itelmex/openledsign/hardware/kicad/openled_esquematico.pdf

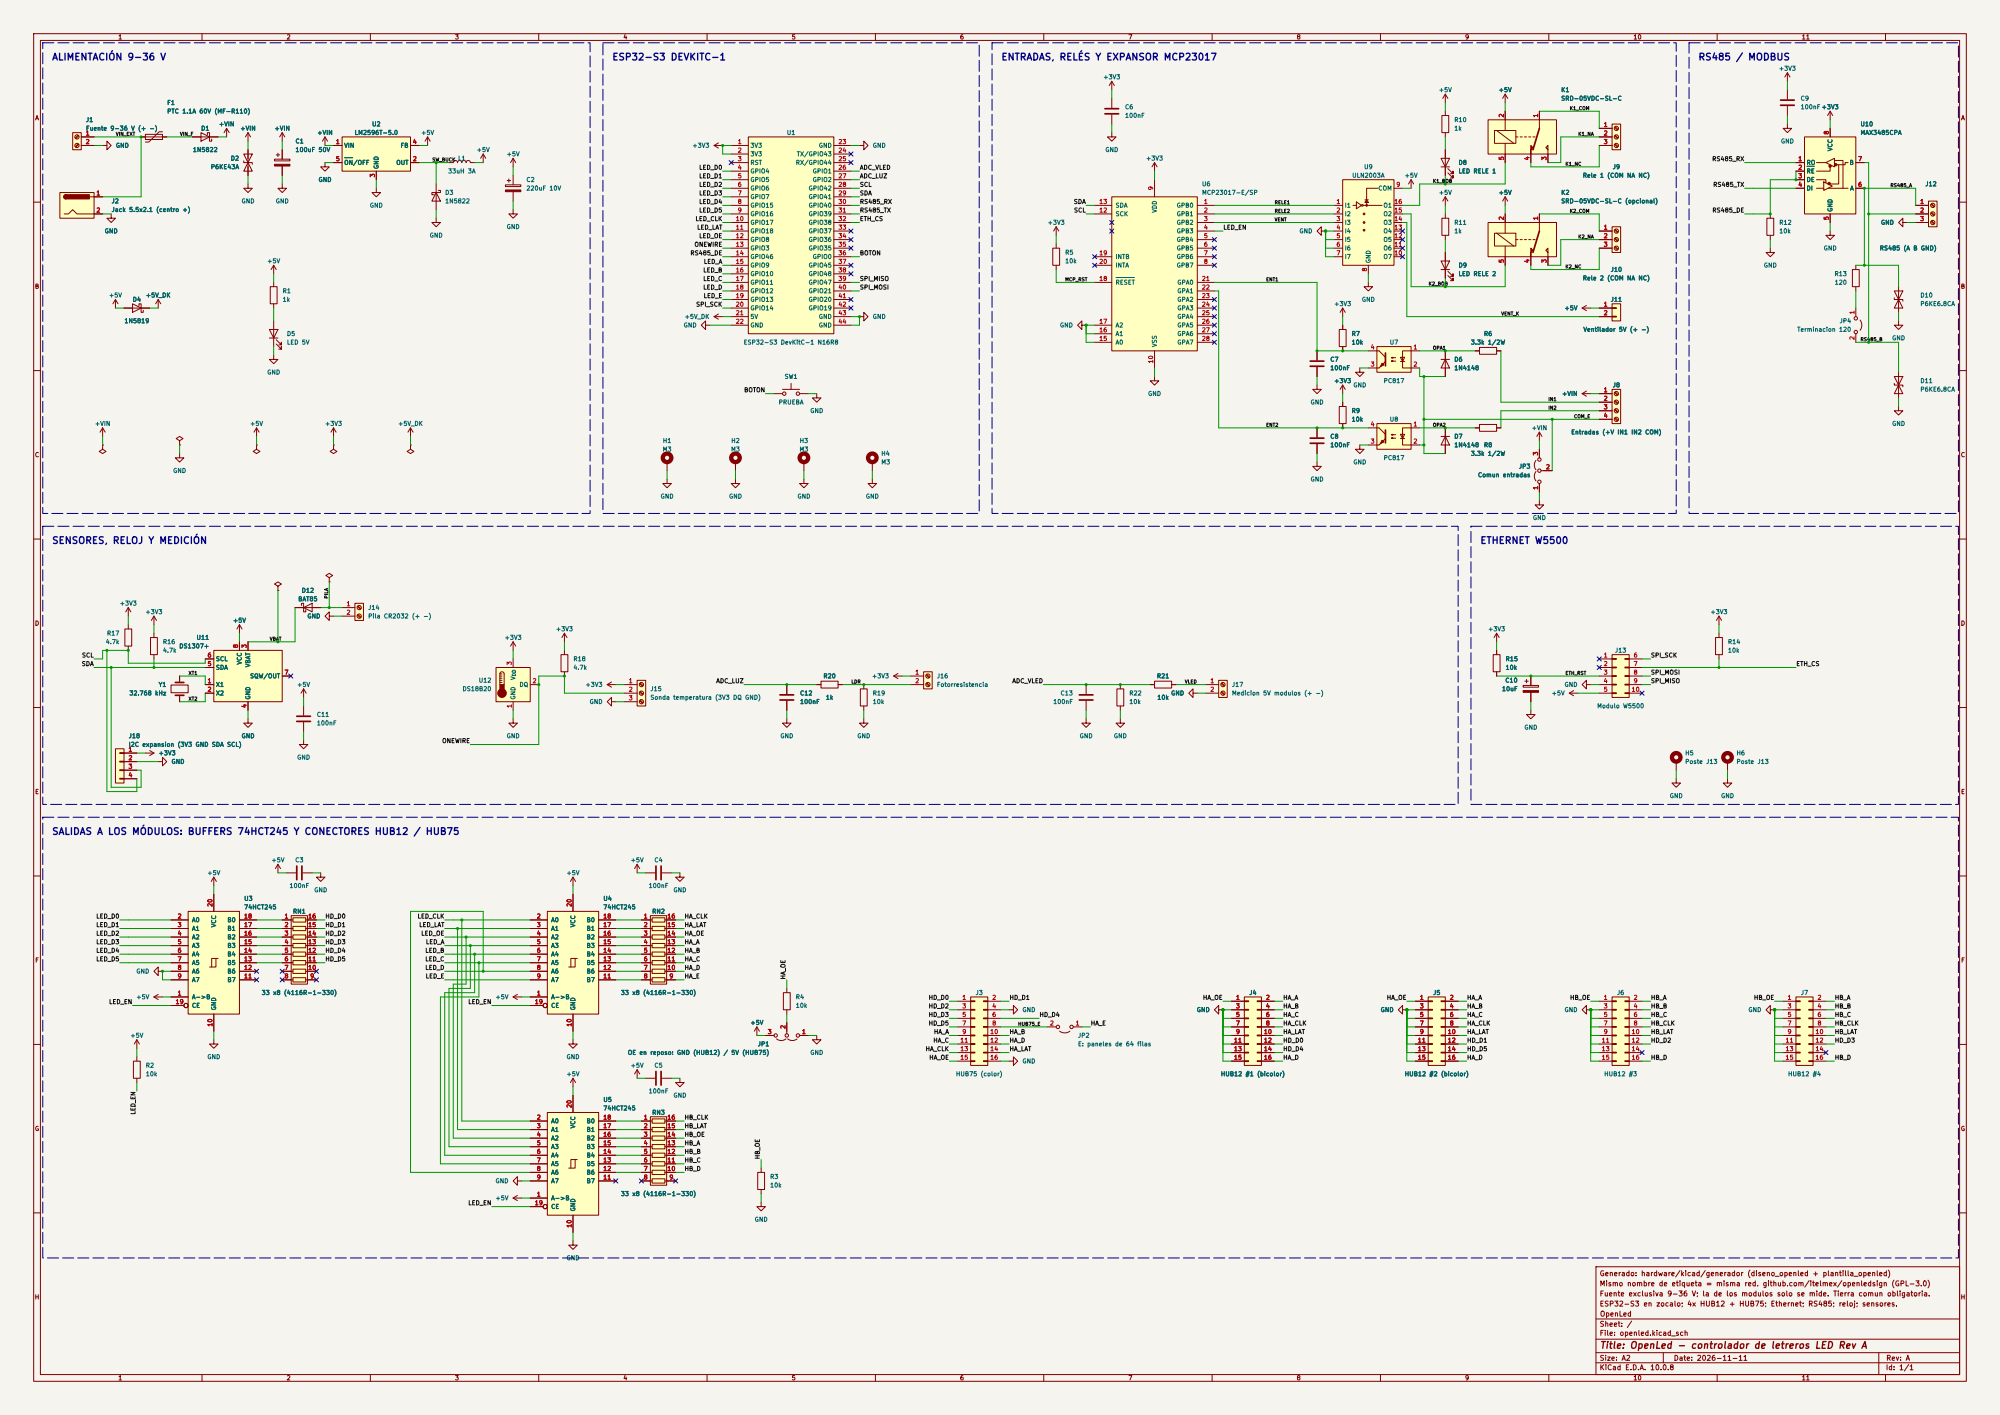
[picture p1: page 1]

J9 Rele 1 (COM NA NC) 1

J10 Rele 2 (COM NA NC) 1

Sonda temperatura (3V3 DQ GND) GND

I2C expansion (3V3 GND SDA SCL)GND

SALIDAS A LOS MÓDULOS: BUFFERS 74HCT245 Y CONECTORES HUB12 / HUB75

9 | 10
11 | 12

JP1 OE en reposo: GND (HUB12) / 5V (HUB75) A->B 1

A3 5 | 33 x8 (4116R-1-330) 1 4 4
A1 3 | 2 2
A2 4 | 3 3

A4 6 | 5 5
A5 7 | 6 6

Generado: hardware/kicad/generador (diseno_openled + plantilla_openled)
Mismo nombre de etiqueta = misma red. github.com/itelmex/openledsign (GPL-3.0)
ESP32-S3 en zocalo; 4x HUB12 + HUB75; Ethernet; RS485; reloj; sensores. Fuente exclusiva 9-36 V; la de los modulos solo se mide. Tierra comun obligatoria.

OpenLed
Sheet: /
File: openled.kicad_sch
Title: OpenLed - controlador de letreros LED Rev A

Size: A2 | Rev: A
KiCad E.D.A. 10.0.8 | Id: 1/1
