itelmex/openledsign/hardware/kicad/openled.kicad_sch

## KiCad design hardware/kicad/openled.kicad_sch (2026-11-11)

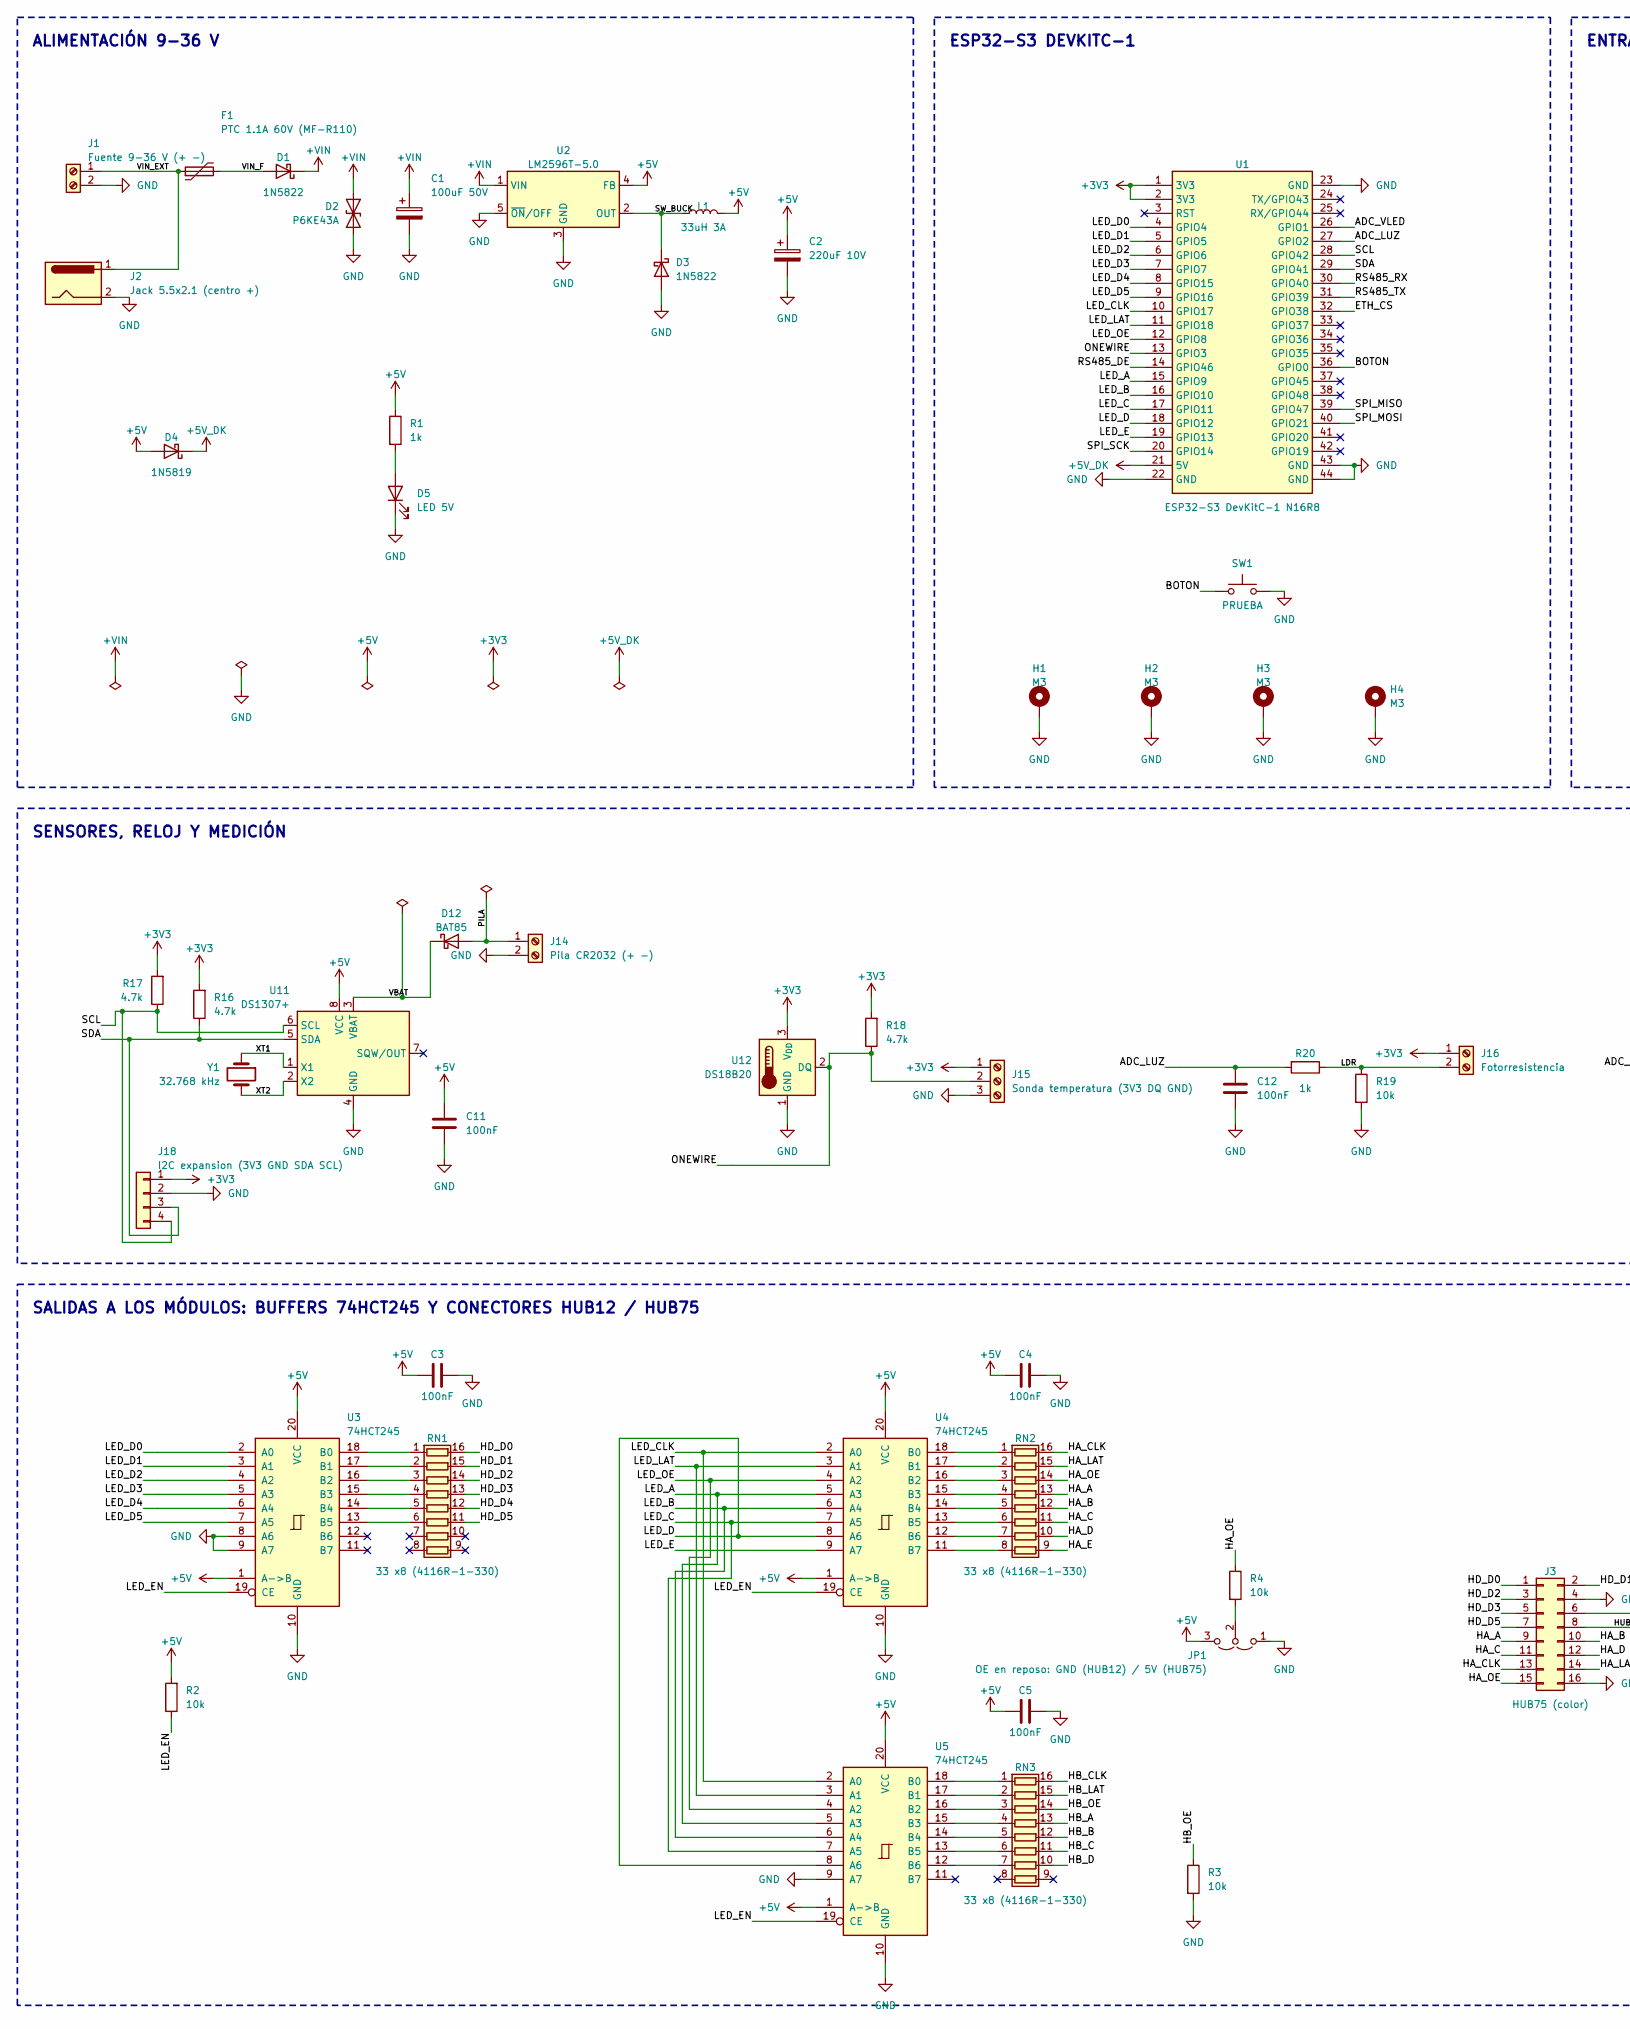
[picture p2: schematic openled.kicad_sch, part in row 1, column 1]

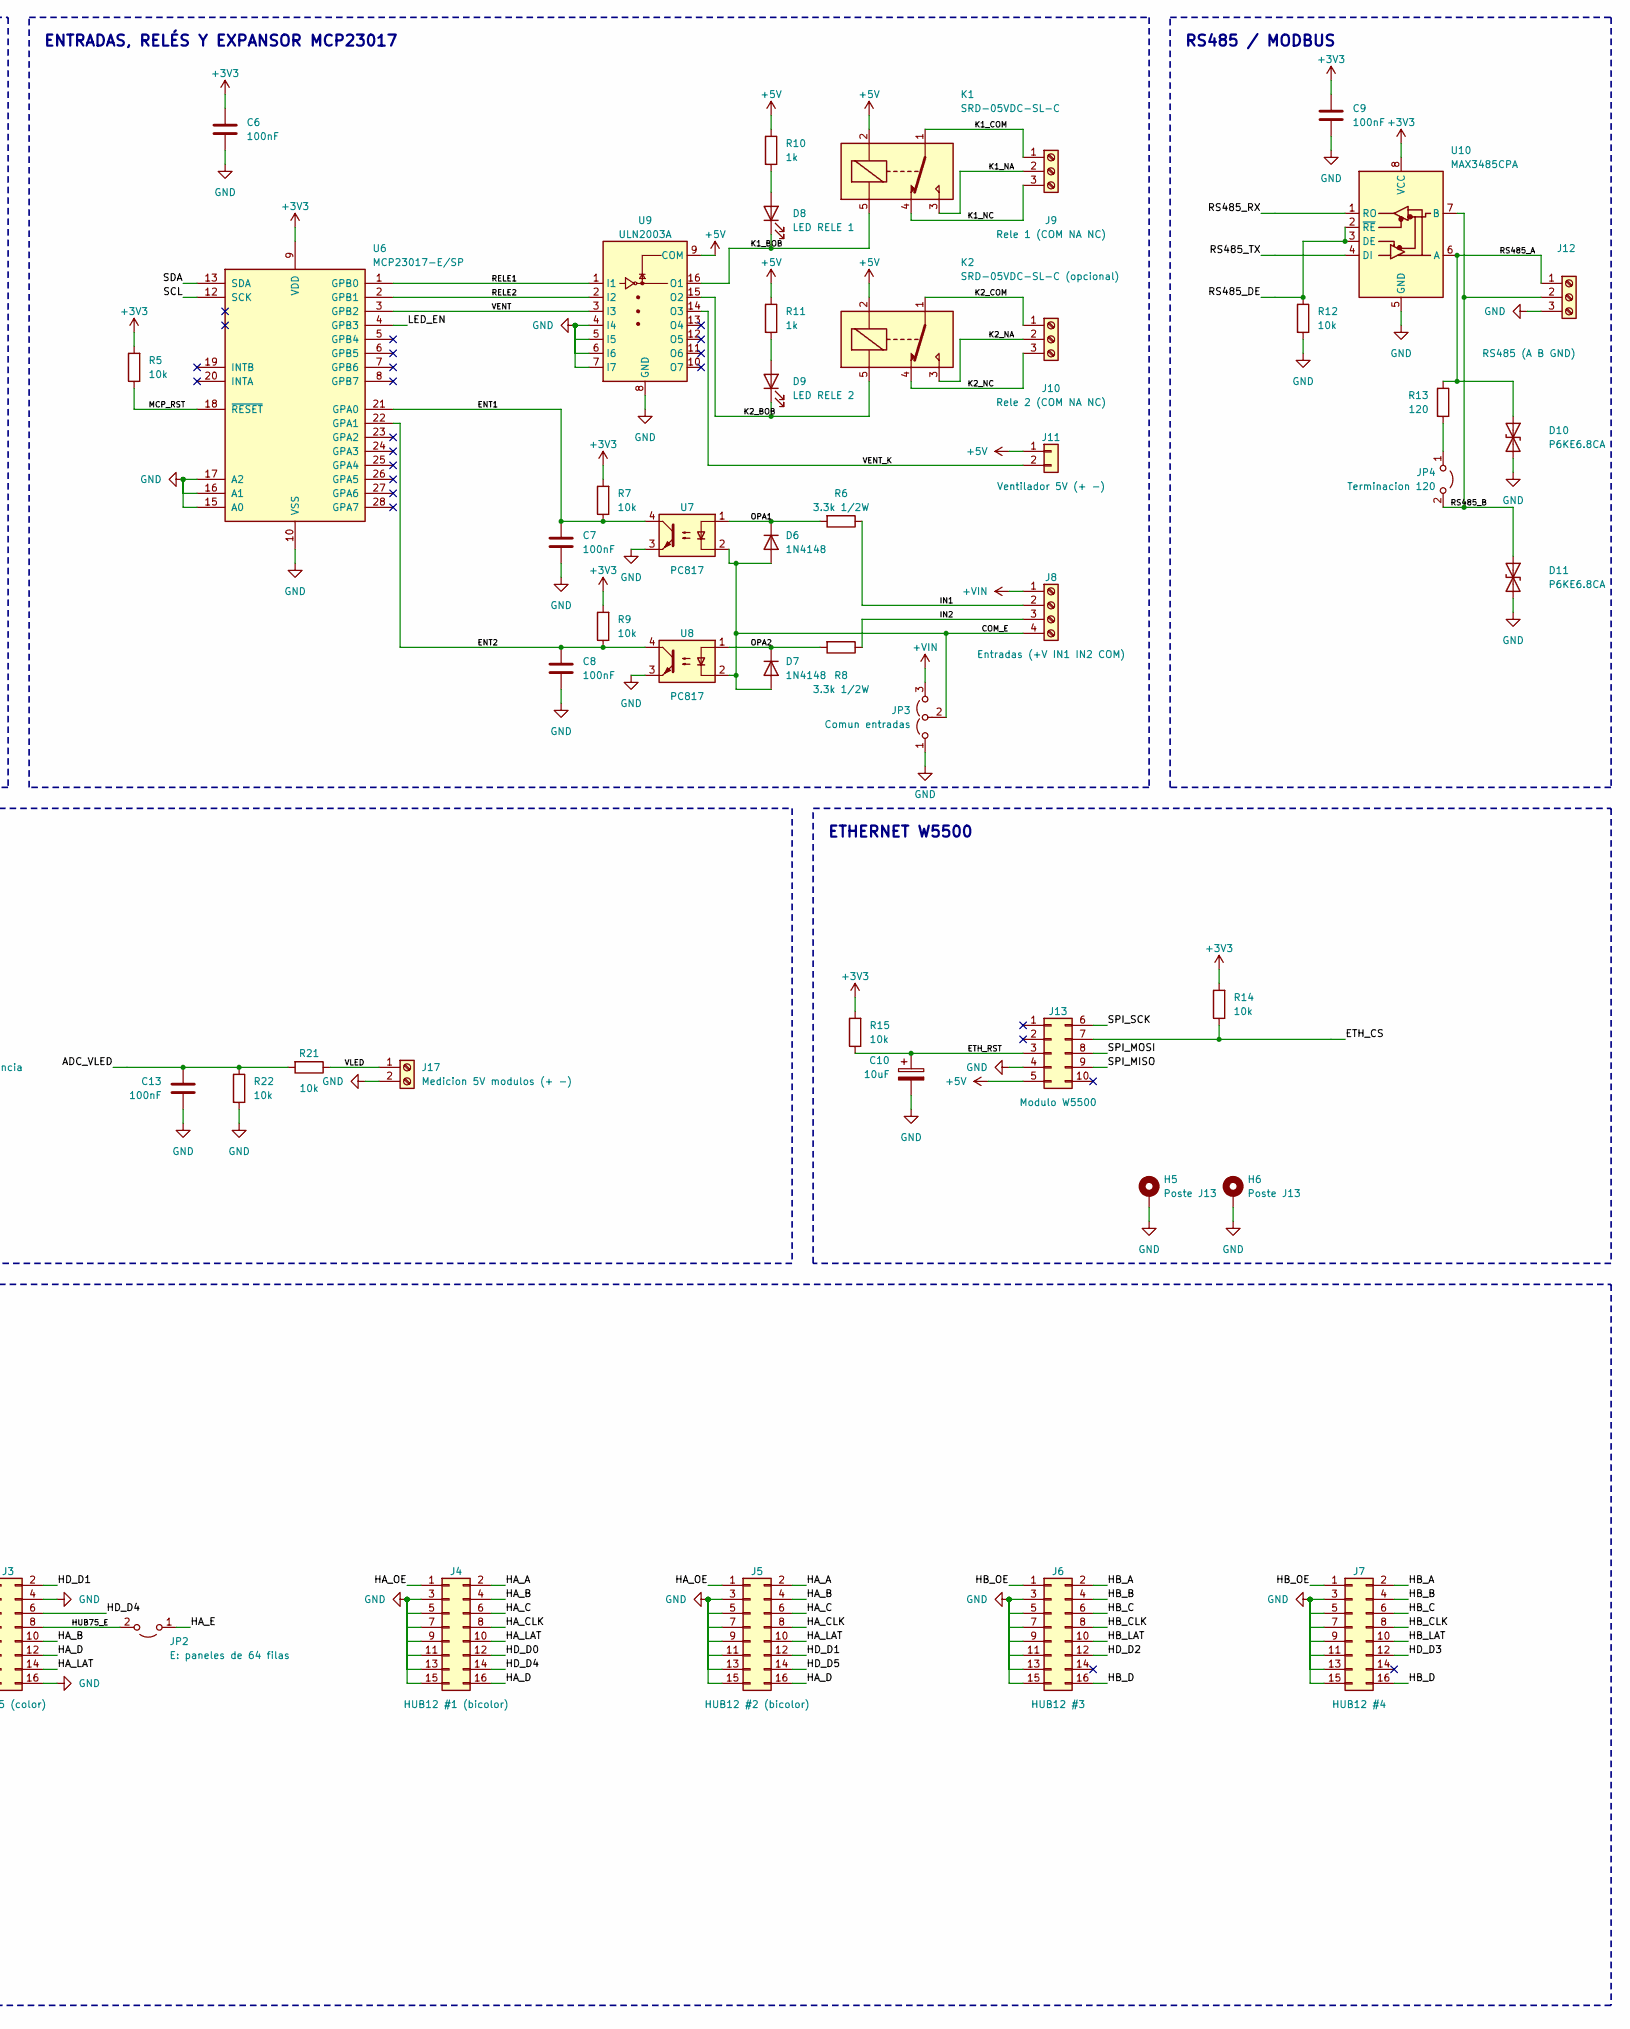
[picture p3: schematic openled.kicad_sch, part in row 1, column 2]

Parts:
C1: 100uF 50V; CP_Radial_D6.3mm_P2.50mm
C2: 220uF 10V; CP_Radial_D6.3mm_P2.50mm
C3, C4, C5, C6, C7, C8, C9, C11, C12, C13: 100nF; C_Disc_D5.0mm_W2.5mm_P5.00mm
C10: 10uF; CP_Radial_D4.0mm_P2.00mm
D1, D3: 1N5822; D_DO-41_SOD81_P10.16mm_Horizontal
D2: P6KE43A; D_DO-15_P12.70mm_Horizontal
D4: 1N5819; D_DO-41_SOD81_P10.16mm_Horizontal
D5: LED 5V; LED_D3.0mm
D6, D7: 1N4148; D_DO-35_SOD27_P7.62mm_Horizontal
D8: LED RELE 1; LED_D3.0mm
D9: LED RELE 2; LED_D3.0mm
D10, D11: P6KE6.8CA; D_DO-15_P12.70mm_Horizontal
D12: BAT85; D_DO-35_SOD27_P7.62mm_Horizontal
F1: PTC 1.1A 60V (MF-R110); Fuse_Bourns_MF-RHT1100
H1, H2, H3, H4: M3; MountingHole_3.2mm_M3_Pad_Via
H5, H6: Poste J13; MountingHole_3.2mm_M3_Pad_Via
J1: Fuente 9-36 V (+ -); PhoenixContact_MSTBA_2,5_2-G-5,08_1x02_P5.08mm_Horizontal
J2: Jack 5.5x2.1 (centro +); BarrelJack_Horizontal
J3: HUB75 (color); IDC-Header_2x08_P2.54mm_Vertical
J4: HUB12 #1 (bicolor); IDC-Header_2x08_P2.54mm_Vertical
J5: HUB12 #2 (bicolor); IDC-Header_2x08_P2.54mm_Vertical
J6: HUB12 #3; IDC-Header_2x08_P2.54mm_Vertical
J7: HUB12 #4; IDC-Header_2x08_P2.54mm_Vertical
J8: Entradas (+V IN1 IN2 COM); PhoenixContact_MC_1,5_4-G-3.5_1x04_P3.50mm_Horizontal
J9: Rele 1 (COM NA NC); PhoenixContact_MSTBA_2,5_3-G-5,08_1x03_P5.08mm_Horizontal
J10: Rele 2 (COM NA NC); PhoenixContact_MSTBA_2,5_3-G-5,08_1x03_P5.08mm_Horizontal
J11: Ventilador 5V (+ -); JST_XH_B2B-XH-A_1x02_P2.50mm_Vertical
J12: RS485 (A B GND); PhoenixContact_MC_1,5_3-G-3.5_1x03_P3.50mm_Horizontal
J13: Modulo W5500; Modulo_W5500
J14: Pila CR2032 (+ -); TerminalBlock_Phoenix_MPT-0,5-2-2.54_1x02_P2.54mm_Horizontal
J15: Sonda temperatura (3V3 DQ GND); PhoenixContact_MC_1,5_3-G-3.5_1x03_P3.50mm_Horizontal
J16: Fotorresistencia; PhoenixContact_MC_1,5_2-G-3.5_1x02_P3.50mm_Horizontal
J17: Medicion 5V modulos (+ -); PhoenixContact_MC_1,5_2-G-3.5_1x02_P3.50mm_Horizontal
J18: I2C expansion (3V3 GND SDA SCL); JST_XH_B4B-XH-A_1x04_P2.50mm_Vertical
JP1: OE en reposo: GND (HUB12) / 5V (HUB75); PinHeader_1x03_P2.54mm_Vertical
JP2: E: paneles de 64 filas; PinHeader_1x02_P2.54mm_Vertical
JP3: Comun entradas; PinHeader_1x03_P2.54mm_Vertical
JP4: Terminacion 120; PinHeader_1x02_P2.54mm_Vertical
K1: SRD-05VDC-SL-C; Relay_SPDT_SANYOU_SRD_Series_Form_C
K2: SRD-05VDC-SL-C (opcional); Relay_SPDT_SANYOU_SRD_Series_Form_C
L1: 33uH 3A; L_Radial_D12.0mm_P5.00mm_Fastron_11P
R1, R10, R11, R20: 1k; R_Axial_DIN0207_L6.3mm_D2.5mm_P7.62mm_Horizontal
R2, R3, R4, R5, R7, R9, R12, R14, R15, R19, R21, R22: 10k; R_Axial_DIN0207_L6.3mm_D2.5mm_P7.62mm_Horizontal
R6, R8: 3.3k 1/2W; R_Axial_DIN0309_L9.0mm_D3.2mm_P12.70mm_Horizontal
R13: 120; R_Axial_DIN0207_L6.3mm_D2.5mm_P7.62mm_Horizontal
R16, R17, R18: 4.7k; R_Axial_DIN0207_L6.3mm_D2.5mm_P7.62mm_Horizontal
RN1, RN2, RN3: 33 x8 (4116R-1-330); DIP-16_W7.62mm
SW1: PRUEBA; SW_PUSH_6mm
U1: ESP32-S3 DevKitC-1 N16R8; ESP32-S3-DevKitC-1_Zocalo
U2: LM2596T-5.0; TO-220-5_P3.4x3.7mm_StaggerOdd_Lead3.8mm_Vertical
U3, U4, U5: 74HCT245; DIP-20_W7.62mm
U6: MCP23017-E/SP; DIP-28_W7.62mm
U7, U8: PC817; DIP-4_W7.62mm
U9: ULN2003A; DIP-16_W7.62mm
U10: MAX3485CPA; DIP-8_W7.62mm
U11: DS1307+; DIP-8_W7.62mm
U12: DS18B20; TO-92_Inline
Y1: 32.768 kHz; Crystal_C26-LF_D2.1mm_L6.5mm_Horizontal

Connections:
+3V3: C6.1, C9.1, J15.1, J16.1, J18.1, R5.2, R7.2, R9.2, R14.2, R15.2, R16.2, R17.2, R18.2, U1.1 (3V3), U1.2 (3V3), U6.9 (VDD), U10.8 (VCC), U12.3 (V_{DD})
+5V: C2.1, C3.1, C4.1, C5.1, C11.1, D4.2 (A), J11.1, J13.5, JP1.3 (B), K1.2, K2.2, L1.2, R1.1, R2.2, R10.1, R11.1, U2.4 (FB), U3.1 (A->B), U3.20 (VCC), U4.1 (A->B), U4.20 (VCC), U5.1 (A->B), U5.20 (VCC), U9.9 (COM), U11.8 (VCC)
+5V_DK: D4.1 (K), U1.21 (5V)
+VIN: C1.1, D1.1 (K), D2.1 (A1), J8.1, JP3.3 (B), U2.1 (VIN)
ADC_LUZ: C12.1, R20.2, U1.27 (GPIO2)
ADC_VLED: C13.1, R21.2, R22.1, U1.26 (GPIO1)
BOTON: SW1.1, U1.36 (GPIO0)
COM_E: D6.2 (A), D7.2 (A), J8.4, JP3.2 (C), U7.2, U8.2
ENT1: C7.1, R7.1, U6.21 (GPA0), U7.4
ENT2: C8.1, R9.1, U6.22 (GPA1), U8.4
ETH_CS: J13.7, R14.1, U1.32 (GPIO38)
ETH_RST: C10.1, J13.3, R15.1
GND: C1.2, C2.2, C3.2, C4.2, C5.2, C6.2, C7.2, C8.2, C9.2, C10.2, C11.2, C12.2, C13.2, D2.2 (A2), D3.2 (A), D5.1 (K), D10.2 (A2), D11.2 (A2), H1.1, H2.1, H3.1, H4.1, H5.1, H6.1, J1.2, J2.2, J3.4, J3.16, J4.3, J4.5, J4.7, J4.9, J4.11, J4.13, J4.15, J5.3, J5.5, J5.7, J5.9, J5.11, J5.13, J5.15, J6.3, J6.5, J6.7, J6.9, J6.11, J6.13, J6.15, J7.3, J7.5, J7.7, J7.9, J7.11, J7.13, J7.15, J12.3, J13.4, J14.2, J15.3, J17.2, J18.2, JP1.1 (A), JP3.1 (A), R3.2, R12.2, R19.2, R22.2, SW1.2, U1.22 (GND), U1.23 (GND), U1.43 (GND), U1.44 (GND), U2.3 (GND), U2.5 (~ON/OFF), U3.8 (A6), U3.9 (A7), U3.10 (GND), U4.10 (GND), U5.9 (A7), U5.10 (GND), U6.10 (VSS), U6.15 (A0), U6.16 (A1), U6.17 (A2), U7.3, U8.3, U9.4 (I4), U9.5 (I5), U9.6 (I6), U9.7 (I7), U9.8 (GND), U10.5 (GND), U11.4 (GND), U12.1 (GND)
HA_A: J3.9, J4.2, J5.2, RN2.13 (R4.2)
HA_B: J3.10, J4.4, J5.4, RN2.12 (R5.2)
HA_C: J3.11, J4.6, J5.6, RN2.11 (R6.2)
HA_CLK: J3.13, J4.8, J5.8, RN2.16 (R1.2)
HA_D: J3.12, J4.16, J5.16, RN2.10 (R7.2)
HA_E: JP2.1 (A), RN2.9 (R8.2)
HA_LAT: J3.14, J4.10, J5.10, RN2.15 (R2.2)
HA_OE: J3.15, J4.1, J5.1, R4.1, RN2.14 (R3.2)
HB_A: J6.2, J7.2, RN3.13 (R4.2)
HB_B: J6.4, J7.4, RN3.12 (R5.2)
HB_C: J6.6, J7.6, RN3.11 (R6.2)
HB_CLK: J6.8, J7.8, RN3.16 (R1.2)
HB_D: J6.16, J7.16, RN3.10 (R7.2)
HB_LAT: J6.10, J7.10, RN3.15 (R2.2)
HB_OE: J6.1, J7.1, R3.1, RN3.14 (R3.2)
HD_D0: J3.1, J4.12, RN1.16 (R1.2)
HD_D1: J3.2, J5.12, RN1.15 (R2.2)
HD_D2: J3.3, J6.12, RN1.14 (R3.2)
HD_D3: J3.5, J7.12, RN1.13 (R4.2)
HD_D4: J3.6, J4.14, RN1.12 (R5.2)
HD_D5: J3.7, J5.14, RN1.11 (R6.2)
HUB75_E: J3.8, JP2.2 (B)
IN1: J8.2, R6.1
IN2: J8.3, R8.1
K1_BOB: D8.1 (K), K1.5, U9.16 (O1)
K1_COM: J9.1, K1.1
K1_NA: J9.2, K1.3
K1_NC: J9.3, K1.4
K2_BOB: D9.1 (K), K2.5, U9.15 (O2)
K2_COM: J10.1, K2.1
K2_NA: J10.2, K2.3
K2_NC: J10.3, K2.4
LDR: J16.2, R19.1, R20.1
LED_A: U1.15 (GPIO9), U4.5 (A3), U5.5 (A3)
LED_B: U1.16 (GPIO10), U4.6 (A4), U5.6 (A4)
LED_C: U1.17 (GPIO11), U4.7 (A5), U5.7 (A5)
LED_CLK: U1.10 (GPIO17), U4.2 (A0), U5.2 (A0)
LED_D: U1.18 (GPIO12), U4.8 (A6), U5.8 (A6)
LED_D0: U1.4 (GPIO4), U3.2 (A0)
LED_D1: U1.5 (GPIO5), U3.3 (A1)
LED_D2: U1.6 (GPIO6), U3.4 (A2)
LED_D3: U1.7 (GPIO7), U3.5 (A3)
LED_D4: U1.8 (GPIO15), U3.6 (A4)
LED_D5: U1.9 (GPIO16), U3.7 (A5)
LED_E: U1.19 (GPIO13), U4.9 (A7)
LED_EN: R2.1, U3.19 (CE), U4.19 (CE), U5.19 (CE), U6.4 (GPB3)
LED_LAT: U1.11 (GPIO18), U4.3 (A1), U5.3 (A1)
LED_OE: U1.12 (GPIO8), U4.4 (A2), U5.4 (A2)
MCP_RST: R5.1, U6.18 (~RESET)
unnamed: D5.2 (A), R1.2
unnamed: D8.2 (A), R10.2
unnamed: D9.2 (A), R11.2
unnamed: JP1.2 (C), R4.2
unnamed: JP4.1 (A), R13.2
unnamed: RN1.1 (R1.1), U3.18 (B0)
unnamed: RN1.2 (R2.1), U3.17 (B1)
unnamed: RN1.3 (R3.1), U3.16 (B2)
unnamed: RN1.4 (R4.1), U3.15 (B3)
unnamed: RN1.5 (R5.1), U3.14 (B4)
unnamed: RN1.6 (R6.1), U3.13 (B5)
unnamed: RN2.1 (R1.1), U4.18 (B0)
unnamed: RN2.2 (R2.1), U4.17 (B1)
unnamed: RN2.3 (R3.1), U4.16 (B2)
unnamed: RN2.4 (R4.1), U4.15 (B3)
unnamed: RN2.5 (R5.1), U4.14 (B4)
unnamed: RN2.6 (R6.1), U4.13 (B5)
unnamed: RN2.7 (R7.1), U4.12 (B6)
unnamed: RN2.8 (R8.1), U4.11 (B7)
unnamed: RN3.1 (R1.1), U5.18 (B0)
unnamed: RN3.2 (R2.1), U5.17 (B1)
unnamed: RN3.3 (R3.1), U5.16 (B2)
unnamed: RN3.4 (R4.1), U5.15 (B3)
unnamed: RN3.5 (R5.1), U5.14 (B4)
unnamed: RN3.6 (R6.1), U5.13 (B5)
unnamed: RN3.7 (R7.1), U5.12 (B6)
ONEWIRE: J15.2, R18.1, U1.13 (GPIO3), U12.2 (DQ)
OPA1: D6.1 (K), R6.2, U7.1
OPA2: D7.1 (K), R8.2, U8.1
PILA: D12.2 (A), J14.1
RELE1: U6.1 (GPB0), U9.1 (I1)
RELE2: U6.2 (GPB1), U9.2 (I2)
RS485_A: D10.1 (A1), J12.1, R13.1, U10.6 (A)
RS485_B: D11.1 (A1), J12.2, JP4.2 (B), U10.7 (B)
RS485_DE: R12.1, U1.14 (GPIO46), U10.2 (~RE), U10.3 (DE)
RS485_RX: U1.30 (GPIO40), U10.1 (RO)
RS485_TX: U1.31 (GPIO39), U10.4 (DI)
SCL: J18.4, R17.1, U1.28 (GPIO42), U6.12 (SCK), U11.6 (SCL)
SDA: J18.3, R16.1, U1.29 (GPIO41), U6.13 (SDA), U11.5 (SDA)
SPI_MISO: J13.9, U1.39 (GPIO47)
SPI_MOSI: J13.8, U1.40 (GPIO21)
SPI_SCK: J13.6, U1.20 (GPIO14)
SW_BUCK: D3.1 (K), L1.1, U2.2 (OUT)
VBAT: D12.1 (K), U11.3 (VBAT)
VENT: U6.3 (GPB2), U9.3 (I3)
VENT_K: J11.2, U9.14 (O3)
VIN_EXT: F1.1, J1.1, J2.1
VIN_F: D1.2 (A), F1.2
VLED: J17.1, R21.1
XT1: U11.1 (X1), Y1.1
XT2: U11.2 (X2), Y1.2

Notes on the sheet:
ALIMENTACIÓN 9-36 V
ESP32-S3 DEVKITC-1
ENTRADAS, RELÉS Y EXPANSOR MCP23017
RS485 / MODBUS
SENSORES, RELOJ Y MEDICIÓN
ETHERNET W5500
SALIDAS A LOS MÓDULOS: BUFFERS 74HCT245 Y CONECTORES HUB12 / HUB75
