itelmex/openledsign/(commit log)

2026-11-11 OpenLed: diseño inicial del controlador abierto de letreros LED
    Exploración (01) y diseño de propósito general (02) de la tarjeta ESP32-S3
    con 4 salidas HUB12 + 1 HUB75, Ethernet, WiFi, RS485/Modbus, sensores y
    protecciones; firmware configurable de 1 a N módulos con mensajes por
    páginas, zonas y elementos. Documentos de estándares y alternativas,
    capacidad e interfaz HUB12. Licencia GPL-3.0.
2026-11-11 OpenLed: esquemático Rev A (KiCad 10) y su generador
    Hoja A2 con 7 bloques: alimentación 9-36 V, ESP32-S3 DevKitC-1, entradas/relés/MCP23017,
    RS485, sensores/reloj/medición, Ethernet W5500 y salidas 74HCT245 a 4 HUB12 + 1 HUB75.
    Revisado contra el diseño: 0 diferencias en 113 redes.
    [openled.kicad_sch]
